Llcoolsouder/Dual-Band-Wireless-Board/README.md

# Dual-Band-Wireless-Board

This board is a proof of concept of a system which will allow seamless wireless data transfer and wireless power simultanneously; even when antennae are extremely close together.
