Llcoolsouder/Dual-Band-Wireless-Board/(list of files, drawings)

Other design files:
AUTOROUTE1.dsn
pcb5.dsn
three.dsn
