Llcoolsouder/Dual-Band-Wireless-Board/DualBand.kicad_pcb

## KiCad design DualBand.kicad_pcb (2017-11-28)

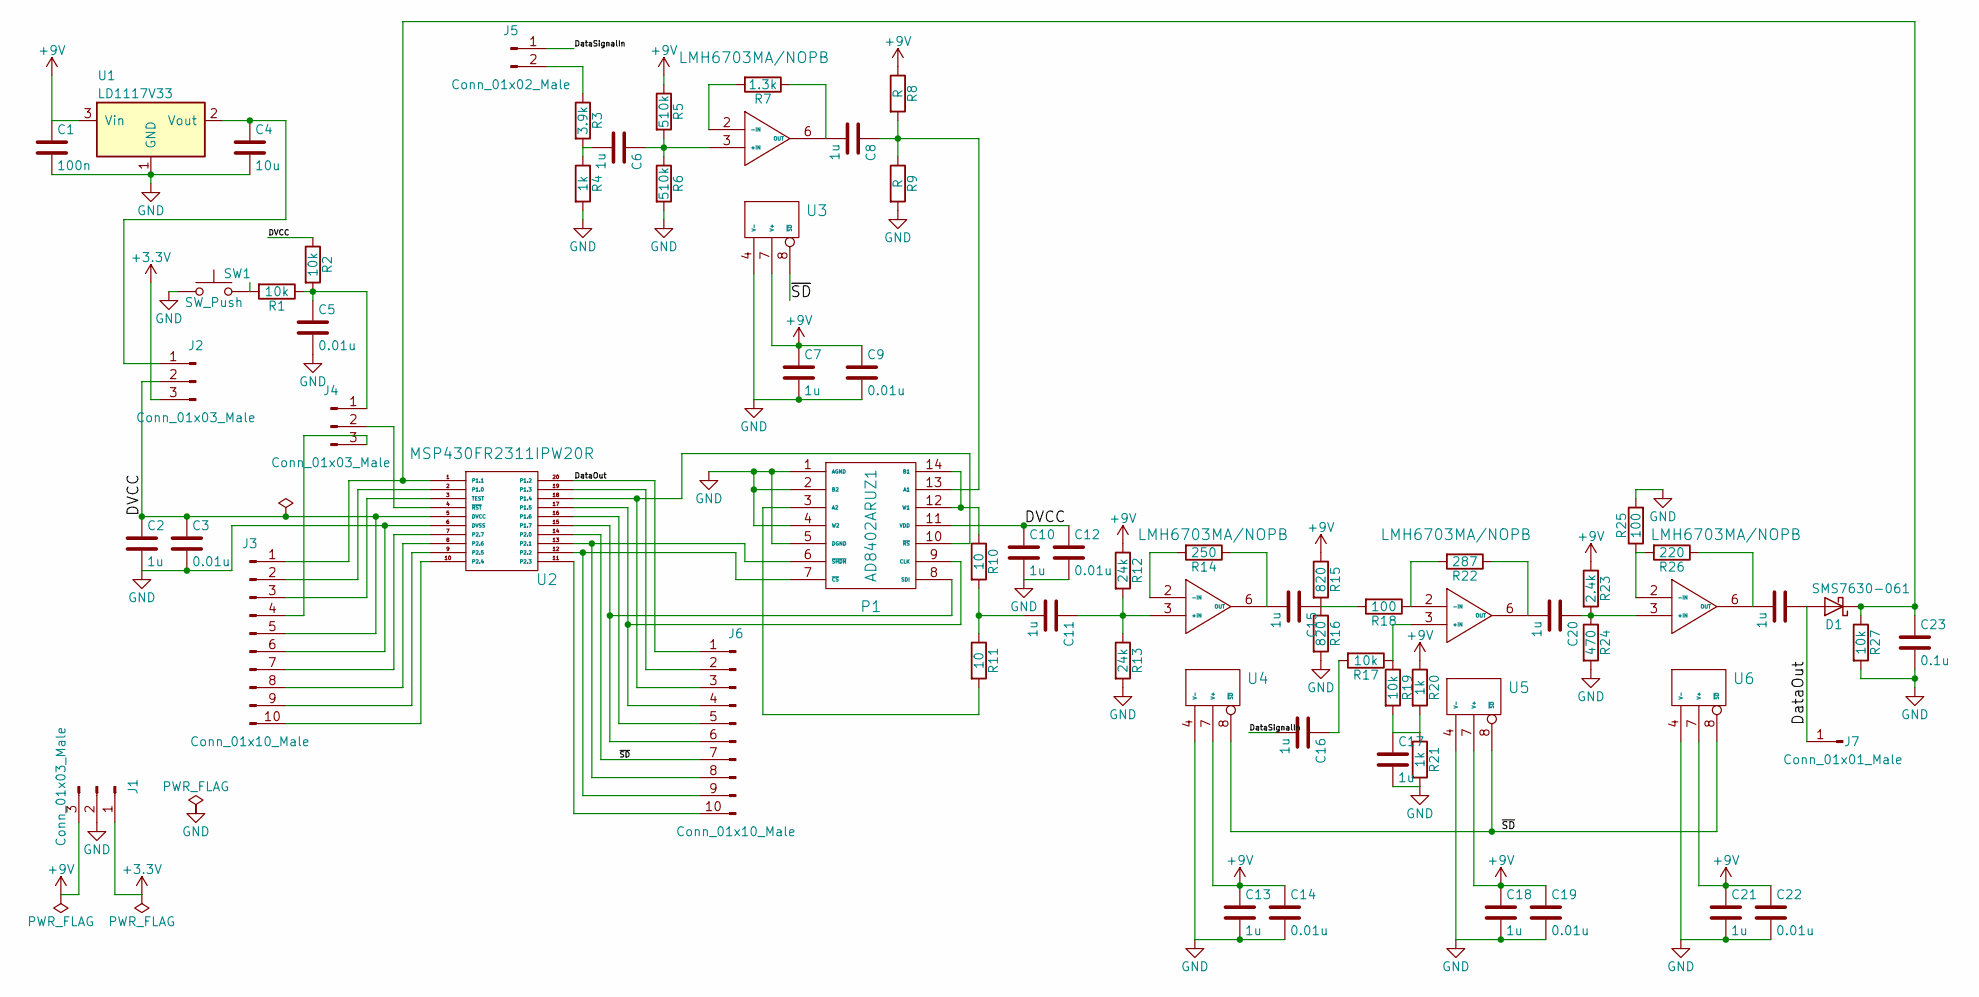
[picture p1: schematic DualBand.sch, Dual Band Wireless System]

Parts:
C1: 100n; C_0603
C2, C6, C7, C8, C10, C11, C13, C15, C16, C17, C18, C20, C21, C24: 1u; C_0603
C3, C5, C9, C12, C14, C19, C22: 0.01u; C_0603
C4: 10u; C_0603
C23: 0.1u; C_0603
D1: SMS7630-061; D_0201
J1, J2, J4: Conn_01x03_Male; Pin_Header_Straight_1x03_Pitch2.54mm
J3, J6: Conn_01x10_Male; Pin_Header_Straight_1x10_Pitch2.54mm
J5: Conn_01x02_Male; Pin_Header_Straight_1x02_Pitch2.54mm
J7: Conn_01x01_Male; Pin_Header_Straight_1x01_Pitch2.54mm
P1: AD8402ARUZ1; TSSOP-14_4.4x5mm_Pitch0.65mm
R1, R2, R17, R19, R27: 10k; R_0603
R3: 3.9k; R_0603
R4, R20, R21: 1k; R_0603
R5, R6: 510k; R_0603
R7: 1.3k; R_0603
R8, R9: R; R_0603
R10, R11: 10; R_0603
R12, R13: 24k; R_0603
R14: 250; R_0603
R15, R16: 820; R_0603
R18, R25: 100; R_0603
R22: 287; R_0603
R23: 2.4k; R_0603
R24: 470; R_0603
R26: 220; R_0603
SW1: SW_Push; FSM2JSMAATR
U1: LD1117V33; TO-220-3_Vertical
U2: MSP430FR2311IPW20R; TSSOP-20_4.4x6.5mm_Pitch0.65mm
U3, U4, U5, U6: LMH6703MA/NOPB; SOIC-8_3.9x4.9mm_Pitch1.27mm

Connections:
+3V3: J1.1, J2.3
+9V: C1.1, C7.1, C9.1, C13.1, C14.1, C18.1, C19.1, C21.1, C22.1, J1.3, R5.1, R8.1, R12.1, R15.1, R20.1, R23.1, U1.3 (Vin), U3.7 (V+), U4.7 (V+), U5.7 (V+), U6.7 (V+)
/DVCC: C2.1, C3.1, C10.1, C12.1, J2.2, J3.5, P1.11 (VDD), R2.1, U2.5 (DVCC)
/DataOut: C24.1, D1.2 (A), J6.1, J7.1, U2.20 (P1.2)
/DataSignalIn: C16.2, J5.1
/~SD: J6.7, U2.14 (P2.0), U3.8 (~SD), U4.8 (~SD), U5.8 (~SD), U6.8 (~SD)
GND: C1.2, C2.2, C3.2, C4.2, C5.2, C7.2, C9.2, C10.2, C12.2, C13.2, C14.2, C17.2, C18.2, C19.2, C21.2, C22.2, C23.2, J1.2, J3.6, P1.1 (AGND), P1.2 (B2), P1.4 (W2), P1.5 (DGND), R4.2, R6.2, R9.2, R13.2, R16.2, R21.2, R24.2, R25.2, R27.2, SW1.1, U1.1 (GND), U2.6 (DVSS), U3.4 (V-), U4.4 (V-), U5.4 (V-), U6.4 (V-)
unnamed: C4.1, J2.1, U1.2 (Vout)
unnamed: C5.1, J4.1, R1.1, R2.2
unnamed: C6.1, R5.2, R6.1, U3.3 (+IN)
unnamed: C6.2, R3.2, R4.1
unnamed: C8.1, P1.13 (A1), R8.2, R9.1
unnamed: C8.2, R7.1, U3.6 (OUT)
unnamed: C11.1, R12.2, R13.1, U4.3 (+IN)
unnamed: C11.2, R10.2, R11.1
unnamed: C15.1, R15.2, R16.1, R18.2
unnamed: C15.2, R14.1, U4.6 (OUT)
unnamed: C16.1, R17.2
unnamed: C17.1, R19.2, R20.2, R21.1
unnamed: C20.1, R23.2, R24.1, U6.3 (+IN)
unnamed: C20.2, R22.1, U5.6 (OUT)
unnamed: C23.1, D1.1 (K), J3.1, R27.1, U2.1 (P1.1)
unnamed: C24.2, R26.1, U6.6 (OUT)
unnamed: J3.2, U2.2 (P1.0)
unnamed: J3.3, U2.3 (TEST)
unnamed: J3.4, J4.3
unnamed: J3.7, U2.7 (P2.7)
unnamed: J3.8, U2.8 (P2.6)
unnamed: J3.9, U2.9 (P2.5)
unnamed: J3.10, U2.10 (P2.4)
unnamed: J4.2, U2.4 (~RST)
unnamed: J5.2, R3.1
unnamed: J6.2, U2.19 (P1.3)
unnamed: J6.3, P1.10 (~RS), U2.18 (P1.4)
unnamed: J6.4, P1.9 (CLK), U2.17 (P1.5)
unnamed: J6.5, U2.16 (P1.6)
unnamed: J6.6, P1.8 (SDI), U2.15 (P1.7)
unnamed: J6.8, P1.6 (~SHDN), U2.13 (P2.1)
unnamed: J6.9, P1.7 (~CS), U2.12 (P2.2)
unnamed: J6.10, U2.11 (P2.3)
unnamed: P1.3 (A2), R11.2
unnamed: P1.12 (W1), P1.14 (B1), R10.1
unnamed: R1.2, SW1.2
unnamed: R7.2, U3.2 (-IN)
unnamed: R14.2, U4.2 (-IN)
unnamed: R17.1, R19.1, U5.3 (+IN)
unnamed: R18.1, R22.2, U5.2 (-IN)
unnamed: R25.1, R26.2, U6.2 (-IN)

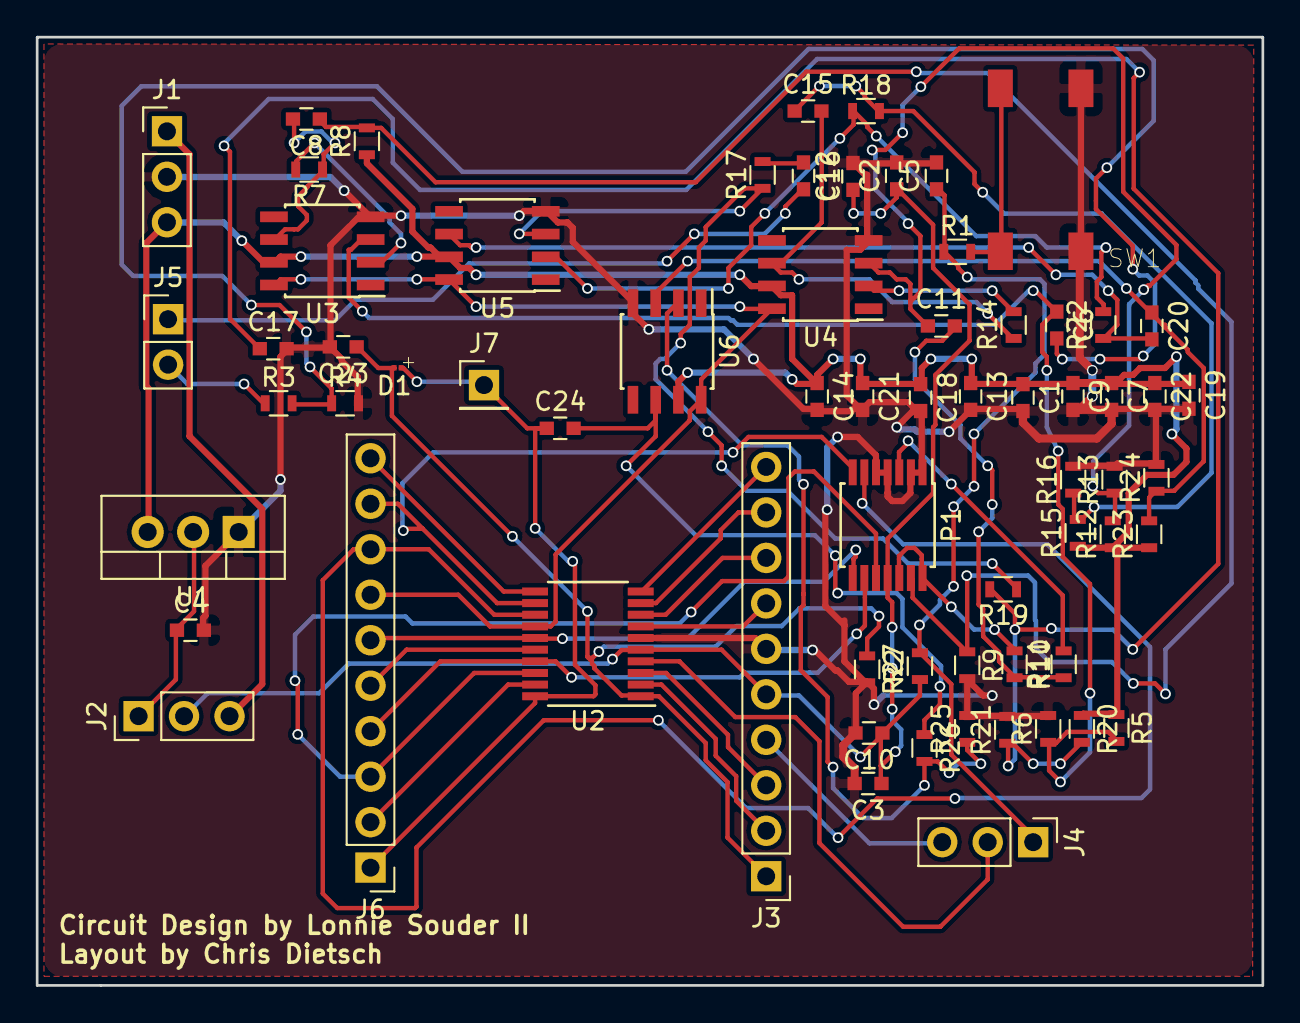
[picture p2: board DualBand.kicad_pcb from above]

Board: 2 copper layers, 68.5 x 53.0 mm, 67 parts (0 on the bottom side), 48 nets.
