Llcoolsouder/Dual-Band-Wireless-Board/(commit log)

2017-10-22 Created project
    [DualBand.kicad_pcb, DualBand.sch]
2017-10-23 Connecting MCU
    [DualBand.sch]
2017-10-23 Schematic almost finished. Needs headers and test points.
    [DualBand.sch]
2017-10-25 Schematic finished. Need to select footprint for 2 more parts
    [DualBand.sch]
2017-10-26 Selected footprints
    [DualBand.sch]
2017-10-26 generated BOM
    [DualBand.csv, DualBand.xlsx]
2017-10-27 fixed button footprint
2017-10-29 Creates the PCB layout; diode footprint messed up?
    [DualBand.kicad_pcb]
2017-10-31 Fixed the PCB edges so they're not enormous
    [DualBand.kicad_pcb]
2017-11-02 Generated Gerbers
    [DualBand-B.Cu.gbl, DualBand-B.Mask.gbs, DualBand-B.SilkS.gbo, DualBand-Edge.Cuts.gm1, DualBand-F.Cu.gtl, DualBand-F.Mask.gts, DualBand-F.SilkS.gto, DualBand.drl]
2017-11-03 Fixed board outline Gerber
    [DualBand-Edge.Cuts.gko]
2017-11-07 Added code for reading from ADC
2017-11-15 Fixed DC levels of amplifiers. Added 3.3V regulator
    [DualBand.sch]
2017-11-18 Recreates PCB based on new layout
    [AUTOROUTE1.dsn, DualBand.kicad_pcb, dualband3.kicad_pcb, pcb4.kicad_pcb, pcb5.dsn, pcb5.kicad_pcb, three.dsn]
2017-11-18 Changed design rule to make DRC not whine about diode
    [pcb5.kicad_pcb]
2017-11-20 New gerbers
    [DualBand.csv, DualBand.xlsx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]
2017-11-28 Revised PCB
    [DualBand-B.Cu.gbl, DualBand-B.Mask.gbs, DualBand-B.SilkS.gbo, DualBand-Edge.Cuts.gko, DualBand-F.Cu.gtl, DualBand-F.Mask.gts, DualBand-F.Paste.gtp, DualBand-F.SilkS.gto]
